cargilgar/Smart-Alarm-using-tinyML/data/models/tflite/quantized_model_architecture.JPG

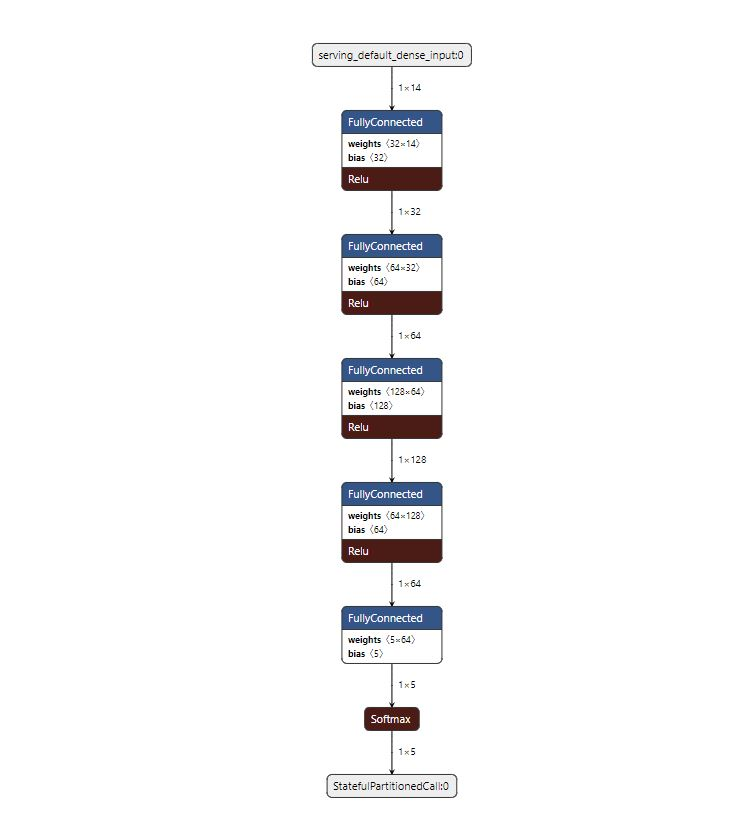
data/models/tflite/quantized_model_architecture.JPG
