cargilgar/Smart-Alarm-using-tinyML/src/arduino/smart_alarm/model.cpp

/* Copyright 2021 Carlos Gil, Daniel Moreno.

Licensed under the Apache License, Version 2.0 (the "License");
you may not use this file except in compliance with the License.
You may obtain a copy of the License at

    https://www.apache.org/licenses/LICENSE-2.0

Unless required by applicable law or agreed to in writing, software
distributed under the License is distributed on an "AS IS" BASIS,
WITHOUT WARRANTIES OR CONDITIONS OF ANY KIND, either express or implied.
See the License for the specific language governing permissions and
limitations under the License.
==============================================================================*/

#include "model.h"

const int smart_alarm_model_len = 23816;

// Alignment requirement to 8 bytes (64-bit).
alignas(8) const unsigned char smart_alarm_model[] = {
  0x20, 0x00, 0x00, 0x00, 0x54, 0x46, 0x4c, 0x33, 0x00, 0x00, 0x00, 0x00,
  0x14, 0x00, 0x20, 0x00, 0x1c, 0x00, 0x18, 0x00, 0x14, 0x00, 0x10, 0x00,
  0x0c, 0x00, 0x00, 0x00, 0x08, 0x00, 0x04, 0x00, 0x14, 0x00, 0x00, 0x00,
  0x1c, 0x00, 0x00, 0x00, 0x1c, 0x00, 0x00, 0x00, 0x4c, 0x00, 0x00, 0x00,
  0xe0, 0x50, 0x00, 0x00, 0xf0, 0x50, 0x00, 0x00, 0x98, 0x5c, 0x00, 0x00,
  0x03, 0x00, 0x00, 0x00, 0x00, 0x00, 0x00, 0x00, 0x01, 0x00, 0x00, 0x00,
  0x0c, 0x00, 0x00, 0x00, 0x08, 0x00, 0x0c, 0x00, 0x08, 0x00, 0x04, 0x00,
  0x08, 0x00, 0x00, 0x00, 0x12, 0x00, 0x00, 0x00, 0x04, 0x00, 0x00, 0x00,
  0x13, 0x00, 0x00, 0x00, 0x6d, 0x69, 0x6e, 0x5f, 0x72, 0x75, 0x6e, 0x74,
  0x69, 0x6d, 0x65, 0x5f, 0x76, 0x65, 0x72, 0x73, 0x69, 0x6f, 0x6e, 0x00,
  0x13, 0x00, 0x00, 0x00, 0x90, 0x50, 0x00, 0x00, 0x88, 0x50, 0x00, 0x00,
  0xb8, 0x4e, 0x00, 0x00, 0x28, 0x4e, 0x00, 0x00, 0x20, 0x4e, 0x00, 0x00,
  0x10, 0x46, 0x00, 0x00, 0x00, 0x45, 0x00, 0x00, 0xf8, 0x44, 0x00, 0x00,
  0xe8, 0x24, 0x00, 0x00, 0xd8, 0x22, 0x00, 0x00, 0xd0, 0x22, 0x00, 0x00,
  0xc0, 0x02, 0x00, 0x00, 0xb0, 0x01, 0x00, 0x00, 0xa8, 0x01, 0x00, 0x00,
  0x58, 0x00, 0x00, 0x00, 0x34, 0x00, 0x00, 0x00, 0x2c, 0x00, 0x00, 0x00,
  0x24, 0x00, 0x00, 0x00, 0x04, 0x00, 0x00, 0x00, 0x22, 0xaf, 0xff, 0xff,
  0x04, 0x00, 0x00, 0x00, 0x10, 0x00, 0x00, 0x00, 0x31, 0x2e, 0x31, 0x34,
  0x2e, 0x30, 0x00, 0x00, 0x00, 0x00, 0x00, 0x00, 0x00, 0x00, 0x00, 0x00,
  0x0c, 0xaf, 0xff, 0xff, 0x10, 0xaf, 0xff, 0xff, 0x46, 0xaf, 0xff, 0xff,
  0x04, 0x00, 0x00, 0x00, 0x14, 0x00, 0x00, 0x00, 0x6e, 0xfe, 0xff, 0xff,
  0x43, 0x00, 0x00, 0x00, 0xc1, 0xfe, 0xff, 0xff, 0xd8, 0x01, 0x00, 0x00,
  0xf8, 0x01, 0x00, 0x00, 0x66, 0xaf, 0xff, 0xff, 0x04, 0x00, 0x00, 0x00,
  0x40, 0x01, 0x00, 0x00, 0x0d, 0x0a, 0x11, 0x24, 0x12, 0x03, 0x18, 0xf5,
  0x0a, 0x00, 0xf8, 0x16, 0x0e, 0x0a, 0x0d, 0xf3, 0xe5, 0x12, 0x04, 0xf4,
  0x07, 0x1c, 0x10, 0x0f, 0x16, 0x36, 0x1e, 0xf8, 0xeb, 0x02, 0xfb, 0xe8,
  0xf4, 0x16, 0x1a, 0x26, 0xea, 0x15, 0x0d, 0x0b, 0xfc, 0xd6, 0x02, 0x20,
  0x0c, 0xd6, 0x10, 0xd1, 0x1c, 0x13, 0x40, 0xe5, 0x13, 0x0f, 0xe4, 0x0c,
  0x1c, 0x13, 0x10, 0x1b, 0xd2, 0x14, 0x07, 0xfd, 0x1d, 0x04, 0x17, 0x1d,
  0x14, 0xe0, 0xed, 0x09, 0x1f, 0x15, 0x03, 0x1a, 0xd6, 0x02, 0x15, 0xe8,
  0xe8, 0xec, 0x07, 0xf7, 0xed, 0x0d, 0xf2, 0x16, 0xfe, 0x28, 0x14, 0xf4,
  0x1e, 0xe9, 0x15, 0x1a, 0x17, 0x0d, 0x18, 0x21, 0x01, 0x10, 0x07, 0xfc,
  0x19, 0xfd, 0xe4, 0x11, 0x13, 0xed, 0x11, 0x19, 0x16, 0x0b, 0x22, 0x07,
  0x1f, 0x15, 0x1a, 0x06, 0xe0, 0x10, 0x08, 0x17, 0x18, 0x12, 0xe7, 0xdd,
  0x0f, 0x0f, 0x08, 0xfa, 0x0c, 0x03, 0xdd, 0x07, 0x02, 0x1a, 0x0c, 0xdb,
  0x06, 0x00, 0x12, 0x09, 0xf9, 0xdd, 0x1a, 0xd0, 0x08, 0xfd, 0x09, 0xe6,
  0x0e, 0x12, 0x24, 0x04, 0xf9, 0x02, 0x12, 0x0d, 0x1b, 0xfc, 0x1a, 0xe0,
  0x19, 0x0d, 0x0d, 0x0a, 0x0b, 0x15, 0x03, 0xe1, 0x17, 0x00, 0x0f, 0x10,
  0xf6, 0xf2, 0xef, 0x11, 0x1d, 0x12, 0x0e, 0xf3, 0xe4, 0x17, 0x0b, 0x1a,
  0x28, 0xff, 0x0a, 0x00, 0x19, 0xc2, 0xcc, 0xc0, 0xa1, 0x03, 0x0d, 0x0a,
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
  
