cargilgar/Smart-Alarm-using-tinyML/src/arduino/smart_alarm/output_handler.cpp

/* Copyright 2021 Carlos Gil, Daniel Moreno.

Licensed under the Apache License, Version 2.0 (the "License");
you may not use this file except in compliance with the License.
You may obtain a copy of the License at

    https://www.apache.org/licenses/LICENSE-2.0

Unless required by applicable law or agreed to in writing, software
distributed under the License is distributed on an "AS IS" BASIS,
WITHOUT WARRANTIES OR CONDITIONS OF ANY KIND, either express or implied.
See the License for the specific language governing permissions and
limitations under the License.
==============================================================================*/

#include "output_handler.h"

TfLiteStatus setupOutputDevice(tflite::ErrorReporter* error_reporter) {
    // TODO: this causes the application to crash on runtime, check another way.
    /*
    // Only when no output device is detected, send error back.
    if ((digitalRead(kMotorPin) > 0) && (digitalRead(kPassiveBuzzerPin) > 0))
        TF_LITE_REPORT_ERROR(error_reporter, "System ready.\n");
    else if (digitalRead(kMotorPin) > 0)
        TF_LITE_REPORT_ERROR(error_reporter, "Buzzer not connected.\n");
    else if (digitalRead(kPassiveBuzzerPin) > 0)
        TF_LITE_REPORT_ERROR(error_reporter, "Vibration motor not connected.\n");
    else
        return kTfLiteError;*/

    return kTfLiteOk;
}

uint8_t recognizeLabel(int8_t* arr, bool msgVerbose) {
    int8_t maxIndex;
    int8_t maxValue = -128;

    for (int8_t i = 0; i < kLabelCount; i++) {
        int8_t temp = *(arr+i);

        if (temp > maxValue) {
            maxIndex = i;
            maxValue = temp;
        }
    }

    // Mapping from (-128, 127) to (0, 100) to express it in percentage
    float probPred = (maxValue + 127)/2.56;

    if (msgVerbose) {
        Serial.print("New label predicted: ");
        Serial.print(maxIndex);
        Serial.print(", with a certainty of: ");
        Serial.print(probPred);
        Serial.print("%.\n\n");
    }

    return maxIndex;
}

uint8_t getMode(uint8_t* arrInferences) {
    /* --------------------------------------------
    Explanatory example of how this function operates

    Input array with the following inference sequence:
        (2, 0, 1, 2, 1, 4, 2, 3, 1, 2)

    Get frequency table for each label and sort them in descending order:
        Wake: 1              N2: 4   <- Most frequent label (mode)
        N1: 3       sort     N1: 3
        N2: 4       ===>     Wake: 1
        N3: 1                N3: 1
        REM: 1               REM: 1
    --------------------------------------------- */

    FreqLabel freqLabelsContainer[kLabelCount] = {
        FreqLabel(LabelStage::Wake),
        FreqLabel(LabelStage::N1),
        FreqLabel(LabelStage::N2),
        FreqLabel(LabelStage::N3),
        FreqLabel(LabelStage::REM)
    };

    _getFreqLabels(arrInferences, freqLabelsContainer);

    _insertionSort(freqLabelsContainer);

    return freqLabelsContainer[0].label;
}

void _getFreqLabels(uint8_t* arr, FreqLabel* labels) {
    for (int i = 0; i < kInferenceSequence; i++)
        labels[arr[i]].freq++;
}

void _insertionSort(FreqLabel* labels) {
    for (int j = 1; j < kLabelCount; j++) {
        int key = labels[j].freq;
        int i = j - 1;

        while ((i > -1) && (labels[i].freq < key)) {
            _swapPointers(labels + i + 1, labels + i);
            i--;
        }
    }
}

void _swapPointers(FreqLabel* ptr1, FreqLabel* ptr2) {
    FreqLabel temp = *ptr1;
    *ptr1 = *ptr2;
    *ptr2 = temp;
}

void triggerAlarm(bool constBeep) {
    if (constBeep) {
        setAlarmOn();
        for (;;) {}
    }
    else {
        for (;;) {
            for (int i = 0; i < 3; i++) {
                setAlarmOn();
                delay(80);
                setAlarmOff();
                delay(80);
            }
            setAlarmOn();
            delay(80);
            setAlarmOff();
            delay(500);
        }
    }
}

void setAlarmOn() {
    digitalWrite(kMotorPin, HIGH);
    tone(kPassiveBuzzerPin, kRingTone);
}

void setAlarmOff() {
    digitalWrite(kMotorPin, LOW);
    noTone(kPassiveBuzzerPin);
}
