cargilgar/Smart-Alarm-using-tinyML/src/arduino/test_hr_sensor/pruebas_hr/pruebas_hr.ino

/*

* Basic BPM Measurement with Pulse Sensor

* Quick Test Sketch for Arduino Uno/Nano

* Adapted code - Thanks to Floris Wouterlood

* T.K.Hareendran/2019

*/




int sensorPin = A0;                                // A0 is the input pin for the heart rate sensor

float sensorValue = 0;                             // Variable to store the value coming from the sensor

int count = 9;

unsigned long starttime = 0;

int heartrate = 0;

boolean counted = false;




void setup (void) {

pinMode (13, OUTPUT);                              // D13 LED as Status Indicator

Serial.begin (9600);                               // Start Serial Communication @ 9600

}




void loop (){




starttime = millis();




while (millis()<starttime+10000)                   // Reading pulse sensor for 10 seconds

{

sensorValue = analogRead(sensorPin);

if (sensorValue > 530 && counted == false)  // Threshold value is 550 (~ 2.7V)

{

count++;

Serial.print ("count = ");

Serial.println (count);

digitalWrite (13,HIGH);

delay (50);

digitalWrite (13, LOW);

counted = true;

}

else if (sensorValue < 550)

{

counted = false;

digitalWrite (13, LOW);

}

}




heartrate = count*6;                               // Multiply the count by 6 to get beats per minute

Serial.println ();

Serial.print ("BPM = ");

Serial.println (heartrate);                        // Display BPM in the Serial Monitor

Serial.println ();

count = 0;




}
