cargilgar/Smart-Alarm-using-tinyML/src/arduino/test_smart_alarm/data_samples.h

/* Copyright 2021 Carlos Gil, Daniel Moreno.

Licensed under the Apache License, Version 2.0 (the "License");
you may not use this file except in compliance with the License.
You may obtain a copy of the License at

    https://www.apache.org/licenses/LICENSE-2.0

Unless required by applicable law or agreed to in writing, software
distributed under the License is distributed on an "AS IS" BASIS,
WITHOUT WARRANTIES OR CONDITIONS OF ANY KIND, either express or implied.
See the License for the specific language governing permissions and
limitations under the License.
==============================================================================*/

#pragma once

#include "constants.h"

/// @file data_samples.h
///
/// @brief Random samples taken from the dataset to test TFLite Micro on Arduino.
///
/// @details This file contains an extract of the dataset resulting from a series
/// of randomly drawn samples. The samples have been automatically generated in 
/// the tflite model training colab.
/// 
/// @note This file could have been presented as a hex dump file or in any other 
/// lossless compression format and then converted back when running the 
/// application. But for the sake of convenience and ease of manipulation, it 
/// is left as it appears in the dataset. 
///
/// @remark Columns: ['X', 'Y', 'Z', 'Heart Rate', 'movement_x', 'movement_y',
/// 'movement_z', 'modulo', 'modulo_movement', 'X**3', 'movement_x**2',
/// 'movement_z**2', 'modulo_movement**2', 'exp_movement_x', 'Labels']
///
/// @see [tflite model training](https://github.com/cargilgar/Smart-Alarm-using-tinyML/blob/main/src/colabs/model_training/tflite_model_training_DNN.ipynb "Model Training colab")

constexpr float samples[kSamplesLength]{
//     X       Y       Z      HR    mov_x   mov_y    mov_z    mod   mod_mov   X^3  mov_x^2 mov_z^2 m_mov^2 e(mov_x) Label
    0.1486, 0.3465, 0.3424, 0.1461, 0.4567, 0.5043, 0.6145, 0.3564, 0.1282, 0.0033, 0.0000, 0.0267, 0.0164, 0.0277, 0,
    0.1630, 0.0370, 0.1912, 0.2921, 0.5346, 0.4219, 0.5169, 0.1699, 0.1239, 0.0043, 0.0211, 0.0005, 0.0154, 0.0464, 0,
    0.1233, 0.0063, 0.2183, 0.1910, 0.4897, 0.4287, 0.5241, 0.1701, 0.0744, 0.0019, 0.0040, 0.0001, 0.0055, 0.0345, 2,
    0.1824, 0.0483, 0.1759, 0.1011, 0.5097, 0.3804, 0.5795, 0.1714, 0.1640, 0.0061, 0.0100, 0.0094, 0.0269, 0.0394, 2,
    0.0233, 0.1201, 0.2121, 0.3933, 0.4165, 0.4979, 0.5241, 0.1709, 0.0654, 0.0000, 0.0051, 0.0001, 0.0043, 0.0213, 4,
    0.0173, 0.0641, 0.2378, 0.2022, 0.4551, 0.4688, 0.5282, 0.1713, 0.0007, 0.0000, 0.0000, 0.0000, 0.0000, 0.0274, 1,
    0.1926, 0.0434, 0.1668, 0.2809, 0.5558, 0.4806, 0.4828, 0.1708, 0.1435, 0.0071, 0.0340, 0.0074, 0.0206, 0.0534, 0,
    0.0799, 0.0411, 0.2323, 0.1236, 0.4548, 0.4693, 0.5282, 0.1712, 0.0007, 0.0005, 0.0000, 0.0000, 0.0000, 0.0274, 1,
    0.1449, 0.1383, 0.1495, 0.2472, 0.4897, 0.4422, 0.5396, 0.1703, 0.0613, 0.0030, 0.0040, 0.0005, 0.0038, 0.0345, 3,
    0.0062, 0.0843, 0.2287, 0.2247, 0.3819, 0.4328, 0.5769, 0.1696, 0.1268, 0.0000, 0.0182, 0.0085, 0.0161, 0.0169, 0,
    0.1157, 0.0063, 0.2233, 0.0674, 0.4554, 0.4693, 0.5285, 0.1711, 0.0004, 0.0016, 0.0000, 0.0000, 0.0000, 0.0275, 1,
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
    0.1558, 0.1622, 0.1119, 0.2135, 0.5234, 0.5067, 0.4640, 0.1712, 0.1350, 0.0038, 0.0156, 0.0148, 0.0182, 0.0431, 0,
    0.0419, 0.1438, 0.1907, 0.3371, 0.4441, 0.5425, 0.5000, 0.1697, 0.1157, 0.0001, 0.0004, 0.0029, 0.0134, 0.0255, 0,
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
};
