cargilgar/Smart-Alarm-using-tinyML/(commit log)

2021-05-12 dataset previsualization
    [hchs-data-dictionary-0.5.0-forms.csv, hchs-sol-sueno-00163225.csv]
2021-05-13 Added dataset
    [Actigraph.csv, Activity.csv, RR.csv, hchs-data-dictionary-0.5.0-forms.csv, hchs-sol-sueno-00163225.csv, questionnaire.csv, saliva.csv, sleep.csv]
2021-05-13 added dataset README
    [Actigraph.csv, Activity.csv, RR.csv, questionnaire.csv, saliva.csv, sleep.csv, user_info.csv]
2021-05-13 moved dataset
    [Actigraph.csv, Activity.csv, RR.csv, questionnaire.csv, saliva.csv, sleep.csv, user_info.csv]
2021-06-03 first dataset created, further revision is still needed
    [dataset_1066528.csv]
2021-06-03 Model updated
    [dataset_1066528.csv]
2021-06-05 oved generate dataset to dataset/ and polished it (ready to use)
    [dataset_1066528.csv]
2021-06-08 Example Dataset
    (1s peak accelerometer, 15s window data)
2021-06-09 Create dataset-1-30.zip
    (1s peak accelerometer, 30s window data)
2021-07-30 model parameters study
    [model _study.xlsx]
2021-08-01 directory cleanup and reorganization
    [model _study.xlsx, model_study.xlsx]
2021-08-01 worked on colab and added saved model
    [model_study.xlsx]
2021-08-02 worked on quantization
    [model_study.xlsx]
2021-08-05 worked on arduino files
2021-08-08 worked on arduino
2021-08-09 test hr sensor
2021-08-09 worked on test arduino
2021-08-11 Testing HR sensor (update)
2021-08-15 worked on usable case for smart alarm
2021-08-19 worked on documentation arduino
2021-08-29 worked on arduino documentation
2021-08-29 Checked missing comments in source files
    [constants.h, heart_rate_handler.cpp, imu_handler.h, input_handler.h, model.cpp, model.h, output_handler.h, queue.h]
2021-08-29 Checked missing comments in test smart alarm application
    [constants.h, data_samples.h, model.cpp, model.h, test_smart_alarm.ino, tflite_test.cpp, tflite_test.h]
2021-08-29 updated model study
    [model_study.xlsx]
2021-08-30 added gif 2nd prototype
2021-08-30 added pictures prototypes
2021-08-30 added prototype 1 gif
